Thiird/stm32F0_devboard/3dmodels/SN74LVC2G04DCKR.step

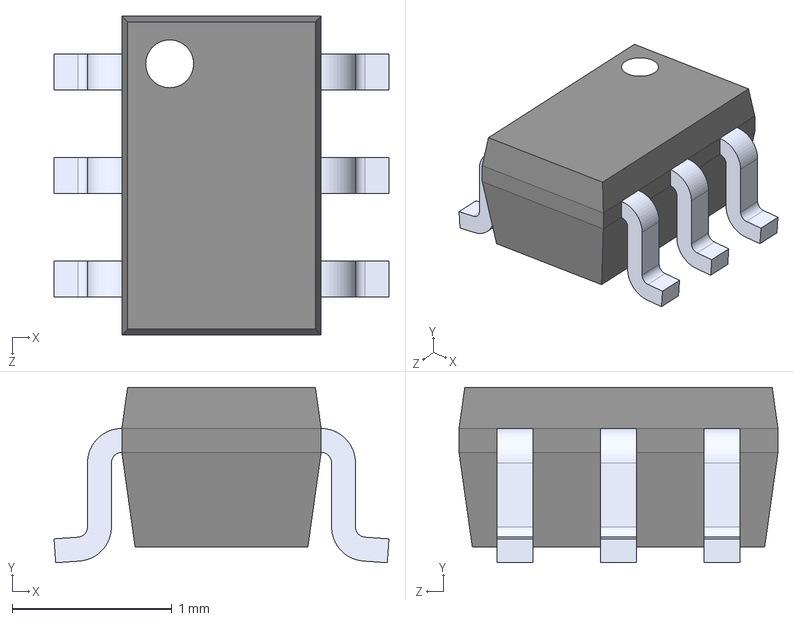
[picture p1: CAD file, 2022-08-30]
3dmodels/SN74LVC2G04DCKR.step
2.10 x 1.10 x 2.00 mm
