Thiird/stm32F0_devboard/3dmodels/SKRPACE010 v4.step

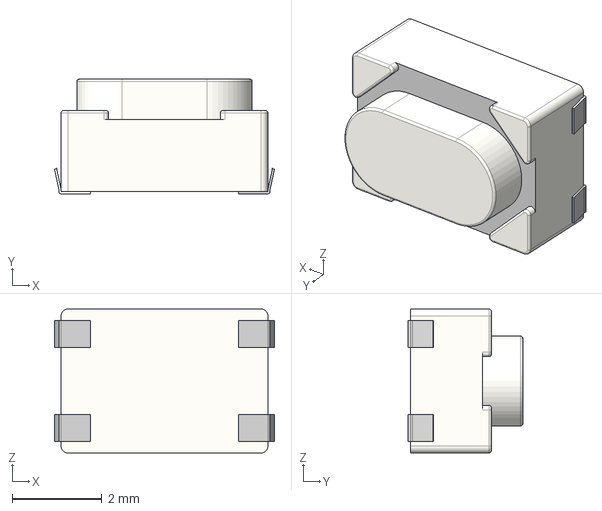
[picture p2: CAD file, 2022-08-30]
3dmodels/SKRPACE010 v4.step
4.89 x 2.55 x 3.20 mm
