Thiird/stm32F0_devboard/stm32f0_dev.kicad_pcb

## KiCad design stm32f0_dev.kicad_pcb (2022-10-26)

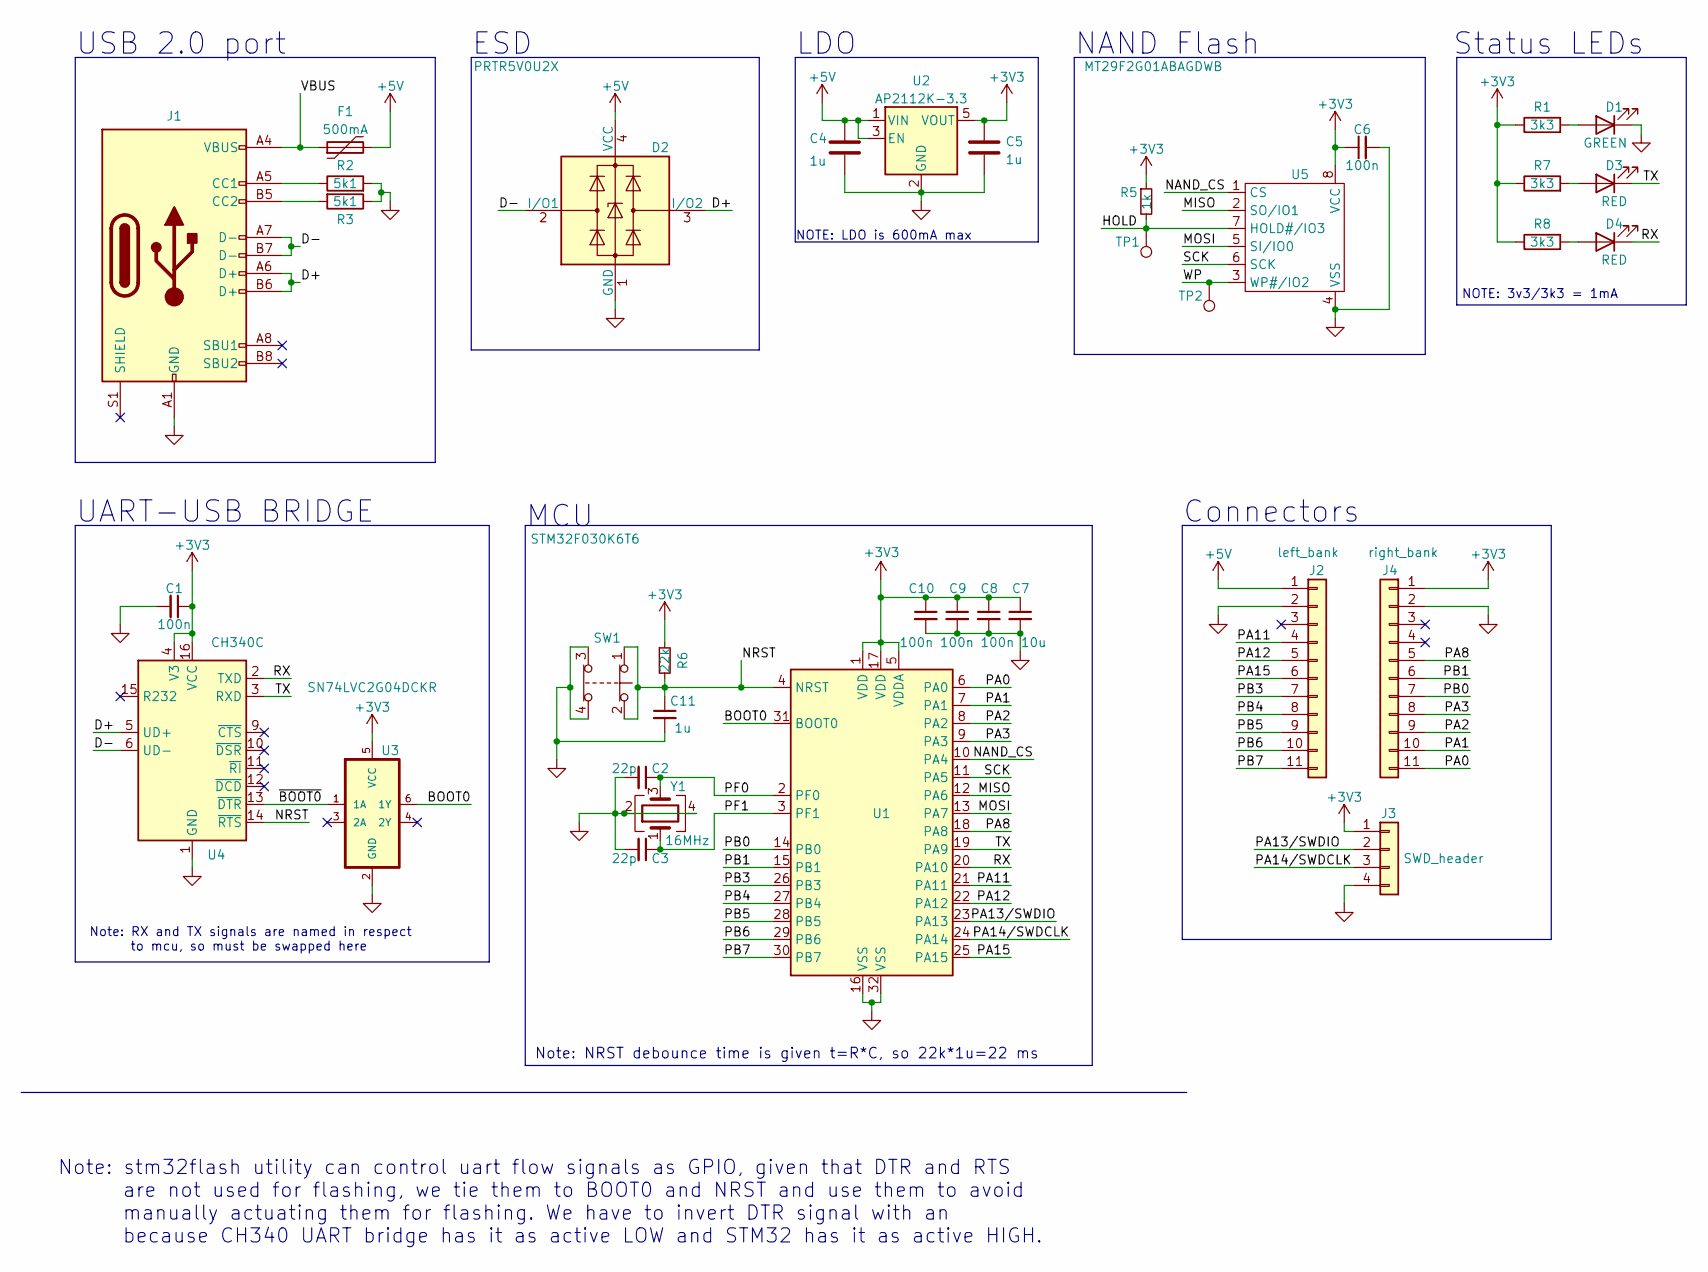
[picture p3: schematic stm32f0_dev.kicad_sch, STM32F030 development board]

Parts:
C1, C6, C8, C9, C10: 100n; C_0603_1608Metric
C2, C3: 22p; C_0603_1608Metric
C4, C5, C11: 1u; C_0603_1608Metric
C7: 10u; C_0603_1608Metric
D1: GREEN; LED_0603_1608Metric
D2: PRTR5V0U2X; SOT-143
D3, D4: RED; LED_0603_1608Metric
F1: 500mA; Fuse_0603_1608Metric
J1: USB_C_Receptacle_USB2.0; USB_C_Receptacle_HRO_TYPE-C-31-M-12
J2: left_bank; PinHeader_1x11_P2.54mm_Vertical
J3: SWD_header; PinHeader_1x04_P2.54mm_Vertical
J4: right_bank; PinHeader_1x11_P2.54mm_Vertical
R1, R7, R8: 3k3; R_0603_1608Metric
R2, R3: 5k1; R_0603_1608Metric
R5: 1k; R_0603_1608Metric
R6: 22k; R_0603_1608Metric
SW1: SW_Push_Open_Dual; SW_SKRPACE010
TP1, TP2: TestPoint; TestPoint_Pad_D1.0mm
U1: STM32F030K6T6; LQFP-32_7x7mm_P0.8mm
U2: AP2112K-3.3; SOT-23-5
U3: SN74LVC2G04DCKR; SOT65P210X110-6N
U4: CH340C; SOIC-16_3.9x9.9mm_P1.27mm
U5: MT29F2G01ABAGDWB; SON127P600X800X65-8N
Y1: 16MHz; Crystal_SMD_2016-4Pin_2.0x1.6mm

Connections:
+3V3: C1.1, C5.1, C6.1, C7.1, C8.1, C9.1, C10.1, J3.1, J4.1, R1.1, R5.1, R6.1, R7.1, R8.1, U1.1 (VDD), U1.5 (VDDA), U1.17 (VDD), U2.5 (VOUT), U3.5 (VCC), U4.4 (V3), U4.16 (VCC), U5.8 (VCC)
+5V: C4.1, D2.4 (VCC), F1.2, J2.1, U2.1 (VIN), U2.3 (EN)
/BOOT0: U1.31 (BOOT0), U3.6 (1Y)
/D+: D2.3 (I/O2), J1.A6 (D+), J1.B6 (D+), U4.5 (UD+)
/D-: D2.2 (I/O1), J1.A7 (D-), J1.B7 (D-), U4.6 (UD-)
/HOLD: R5.2, TP1.1, U5.7 (HOLD#/IO3)
/MISO: U1.12 (PA6), U5.2 (SO/IO1)
/MOSI: U1.13 (PA7), U5.5 (SI/IO0)
/NAND_CS: U1.10 (PA4), U5.1 (CS)
/NRST: C11.1, R6.2, SW1.1, SW1.2, U1.4 (NRST), U4.14 (~RTS)
/PA0: J4.11, U1.6 (PA0)
/PA1: J4.10, U1.7 (PA1)
/PA2: J4.9, U1.8 (PA2)
/PA3: J4.8, U1.9 (PA3)
/PA8: J4.5, U1.18 (PA8)
/PA11: J2.4, U1.21 (PA11)
/PA12: J2.5, U1.22 (PA12)
/PA13/SWDIO: J3.2, U1.23 (PA13)
/PA14/SWDCLK: J3.3, U1.24 (PA14)
/PA15: J2.6, U1.25 (PA15)
/PB0: J4.7, U1.14 (PB0)
/PB1: J4.6, U1.15 (PB1)
/PB3: J2.7, U1.26 (PB3)
/PB4: J2.8, U1.27 (PB4)
/PB5: J2.9, U1.28 (PB5)
/PB6: J2.10, U1.29 (PB6)
/PB7: J2.11, U1.30 (PB7)
/PF0: C2.1, U1.2 (PF0), Y1.3
/PF1: C3.1, U1.3 (PF1), Y1.1
/RX: D4.1 (K), U1.20 (PA10), U4.2 (TXD)
/SCK: U1.11 (PA5), U5.6 (SCK)
/TX: D3.1 (K), U1.19 (PA9), U4.3 (RXD)
/VBUS: F1.1, J1.A4 (VBUS), J1.A9 (VBUS), J1.B4 (VBUS), J1.B9 (VBUS)
/WP: TP2.1, U5.3 (WP#/IO2)
/~BOOT0: U3.1 (1A), U4.13 (~DTR)
GND: C1.2, C2.2, C3.2, C4.2, C5.2, C6.2, C7.2, C8.2, C9.2, C10.2, C11.2, D1.1 (K), D2.1 (GND), J1.A1 (GND), J1.A12 (GND), J1.B1 (GND), J1.B12 (GND), J2.2, J3.4, J4.2, R2.2, R3.1, SW1.3, SW1.4, U1.16 (VSS), U1.32 (VSS), U2.2 (GND), U3.2 (GND), U4.1 (GND), U5.4 (VSS), Y1.2, Y1.4
unnamed: D1.2 (A), R1.2
unnamed: D3.2 (A), R7.2
unnamed: D4.2 (A), R8.2
unnamed: J1.A5 (CC1), R2.1
unnamed: J1.B5 (CC2), R3.2

Notes on the sheet:
NAND Flash
ESD
NOTE: LDO is 600mA max
LDO
UART-USB BRIDGE
MCU
Note: stm32flash utility can control uart flow signals as GPIO, given that DTR and RTS are not used for flashing, we tie them to BOOT0 and NRST and use them to avoid manually actuating them for flashing. We have to invert DTR signal with an because CH340 UART bridge has it as active LOW and STM32 h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
Connectors
Note: RX and TX signals are named in respect to mcu, so must be swapped here
USB 2.0 port
NOTE: 3v3/3k3 = 1mA
Note: NRST debounce time is given t=R*C, so 22k*1u=22 ms
Status LEDs

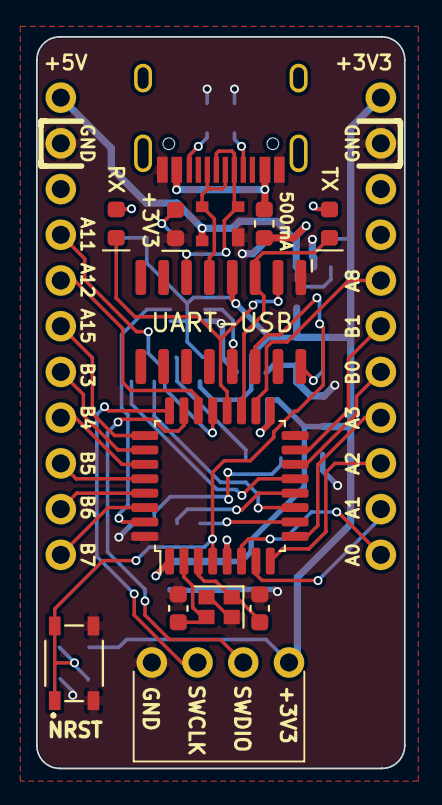
[picture p4: board stm32f0_dev.kicad_pcb from above]

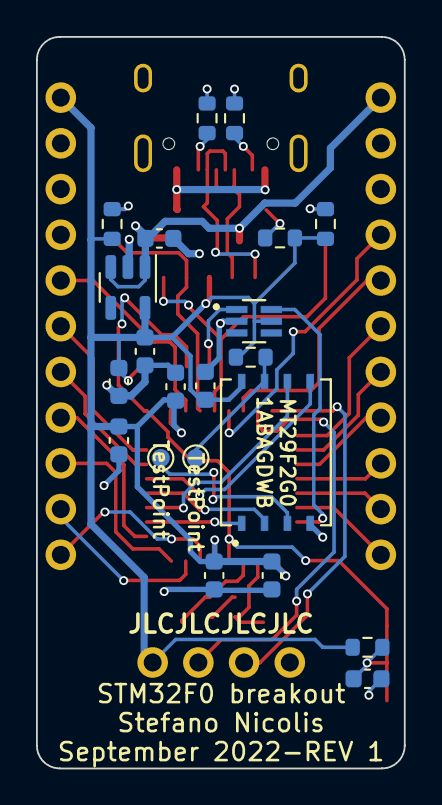
[picture p5: board stm32f0_dev.kicad_pcb from below]

Board: 2 copper layers, 20.4 x 40.6 mm, 36 parts (21 on the bottom side), 41 nets.
