Thiird/stm32F0_devboard/(commit log)

2022-08-30 First commit, board mostly complete
    [SKRPACE010 v4.step, SN74LVC2G04DCKR.step, stm32f0_dev.kicad_pcb, stm32f0_dev.kicad_sch]
2022-08-31 Schematic done, routing done, to fix issues on board
    [stm32f0_dev.kicad_pcb, stm32f0_dev.kicad_sch]
2022-09-02 Finished board, added gerber folder, uart leds, board dimensions
    [stm32f0_dev.kicad_pcb, stm32f0_dev.kicad_sch]
2022-09-20 Fixed nrst button, dtr signal
    [stm32f0_dev.kicad_pcb, stm32f0_dev.kicad_sch]
2022-10-26 Removed useless boot0 switch, uart IC is driving that signal
    [stm32f0_dev.kicad_pcb, stm32f0_dev.kicad_sch]
